Misterobots/Model_Work/docs/img/fit_side.png

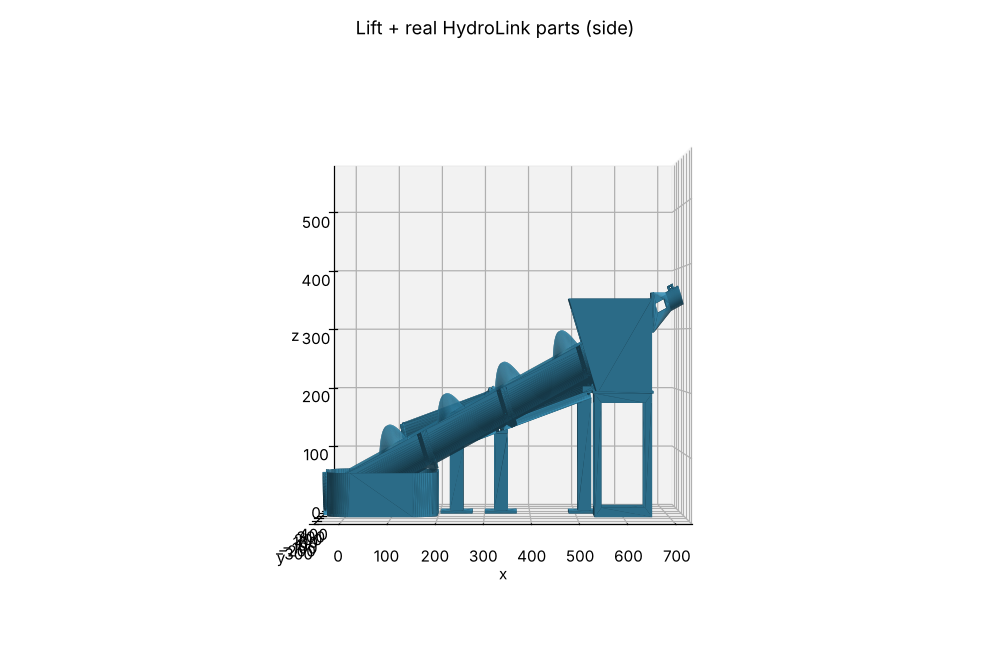
docs/img/fit_side.png
