Misterobots/Model_Work/docs/img/fit_top.png

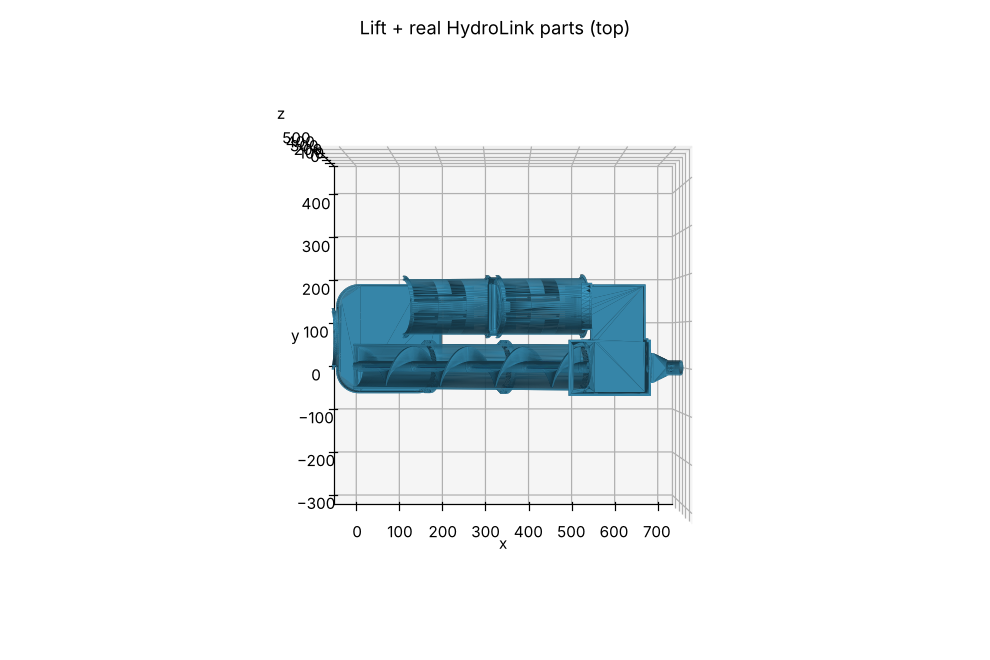
docs/img/fit_top.png
