Misterobots/Model_Work/docs/img/head_box.png

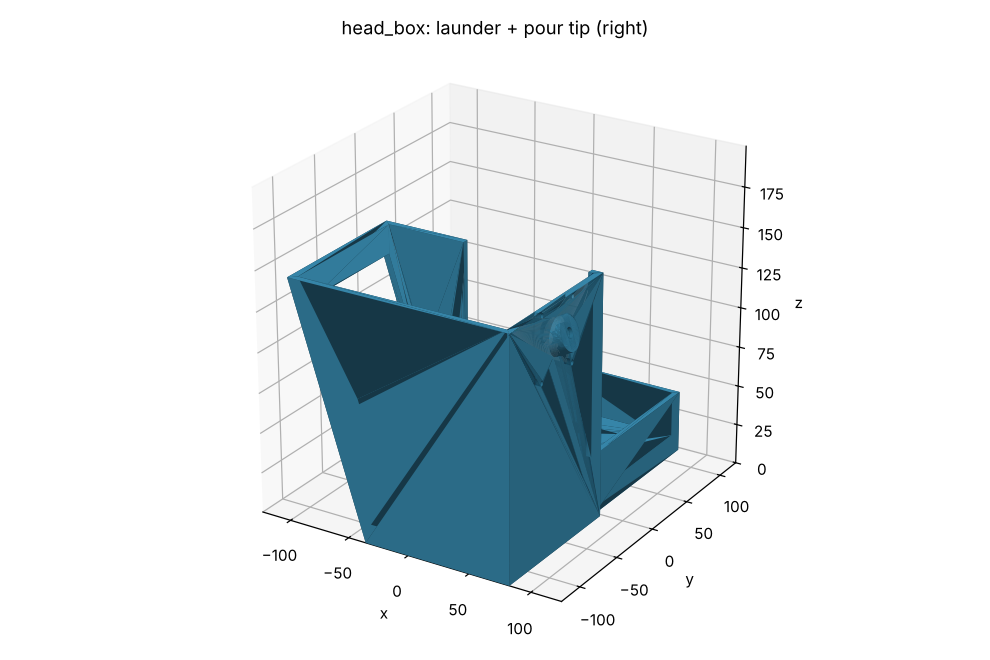
docs/img/head_box.png
