Misterobots/Model_Work/docs/img/screw_segment.png

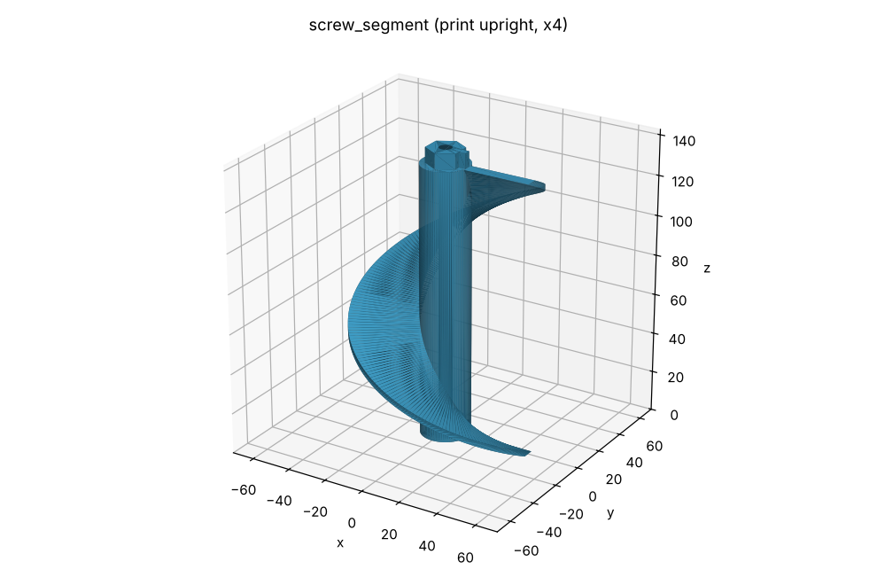
docs/img/screw_segment.png
