Misterobots/Model_Work/docs/img/trough_tail.png

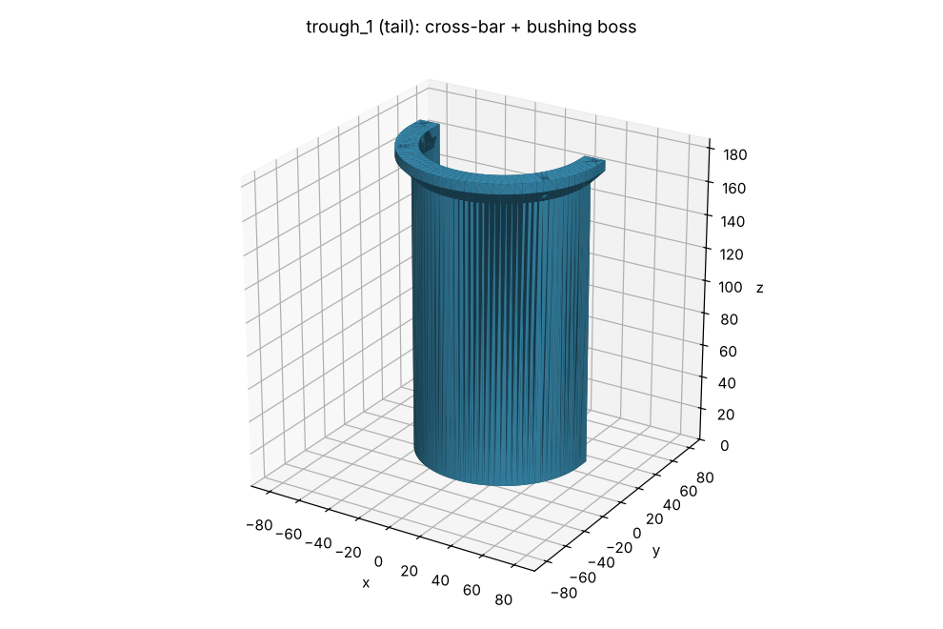
docs/img/trough_tail.png
