Misterobots/Model_Work/cad/lift/stl/_assembly.stl

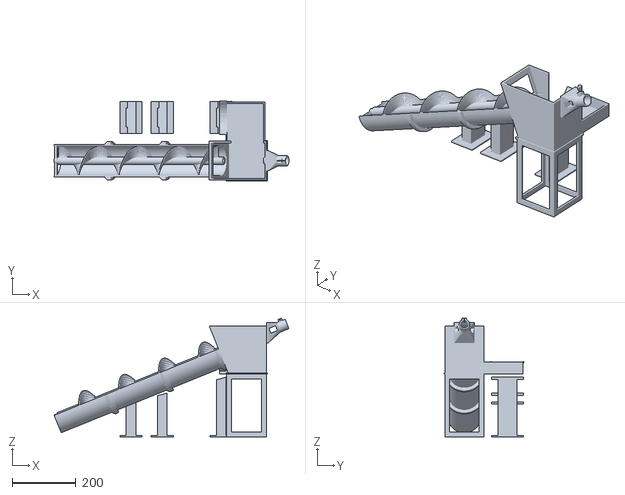
[picture p7: CAD file, 2026-10-11]
cad/lift/stl/_assembly.stl
737.1 x 251.4 x 372.4
