Misterobots/Model_Work/cad/lift/stl/riser_183mm.stl

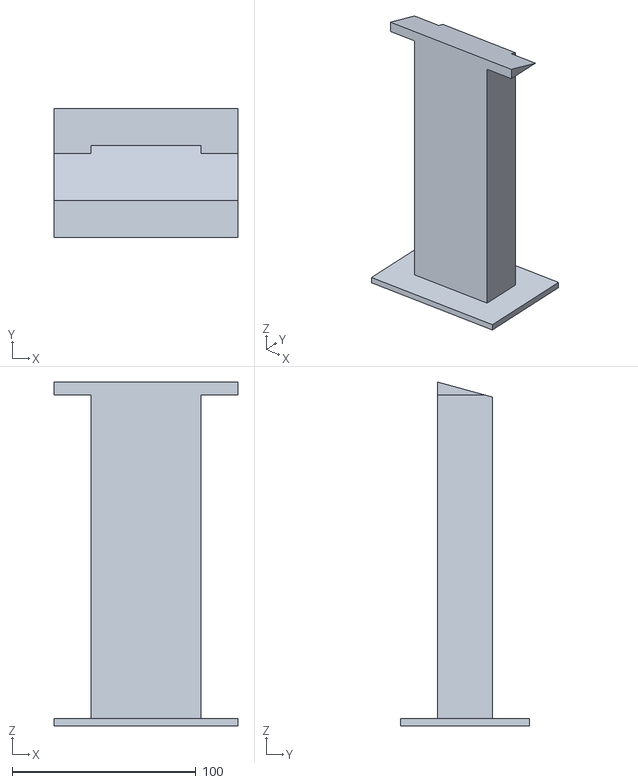
[picture p8: CAD file, 2026-10-11]
cad/lift/stl/riser_183mm.stl
100.0 x 70.0 x 187.1
