Misterobots/Model_Work/cad/lift/stl/head_box.stl

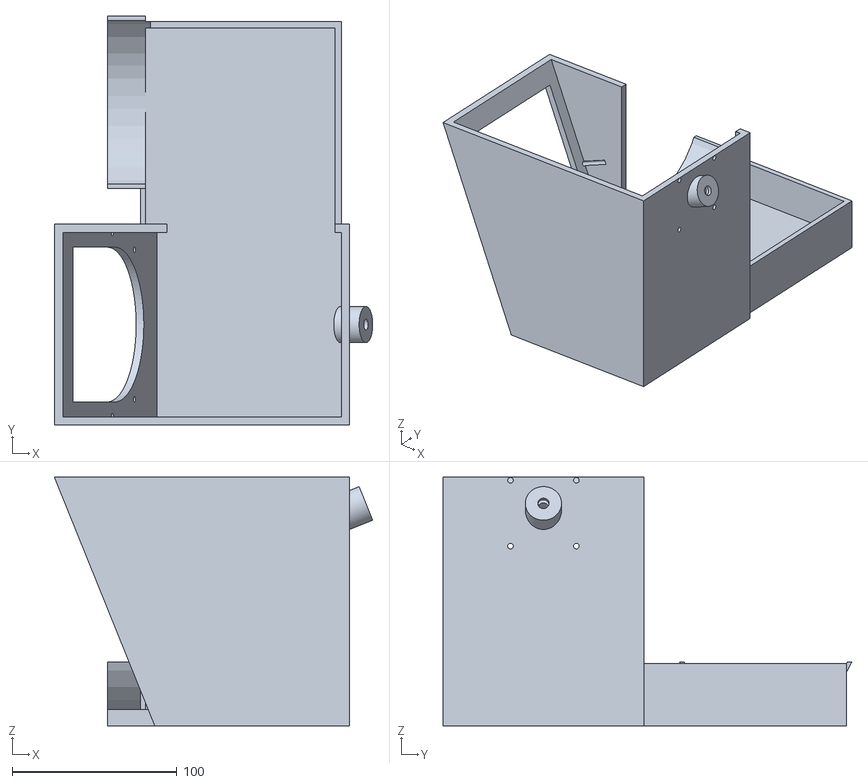
[picture p9: CAD file, 2026-10-11]
cad/lift/stl/head_box.stl
193.4 x 248.4 x 151.2
