Misterobots/Model_Work/cad/lift/stl/riser_106mm.stl

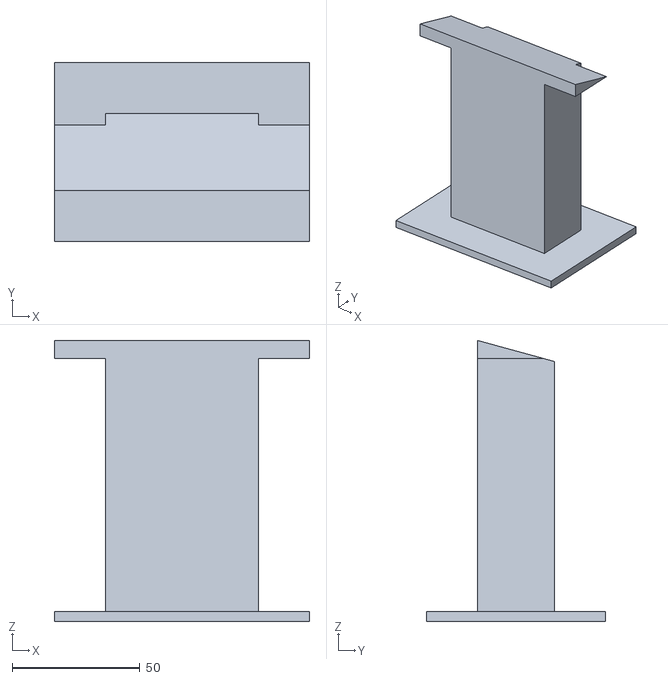
[picture p10: CAD file, 2026-10-11]
cad/lift/stl/riser_106mm.stl
100.0 x 70.0 x 110.1
