Misterobots/Model_Work/cad/lift/stl/riser_133mm.stl

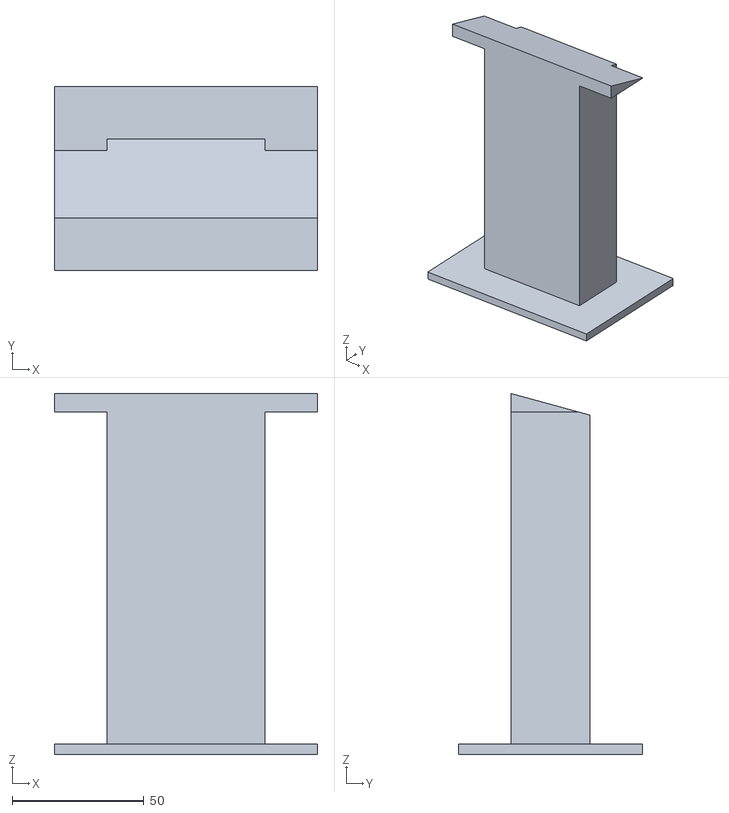
[picture p11: CAD file, 2026-10-11]
cad/lift/stl/riser_133mm.stl
100.0 x 70.0 x 137.1
