Misterobots/Model_Work/cad/lift/stl/trough_3_of_3_top.stl

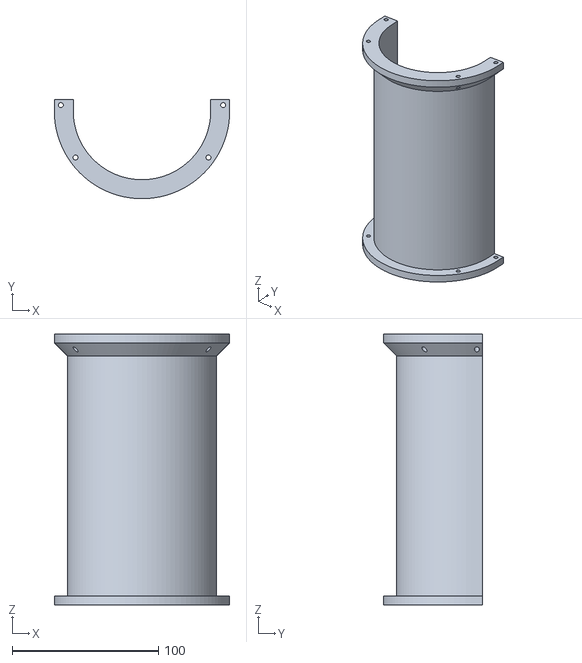
[picture p12: CAD file, 2026-10-11]
cad/lift/stl/trough_3_of_3_top.stl
120.0 x 68.0 x 185.3
