Misterobots/Model_Work/cad/lift/stl/head_box_stand.stl

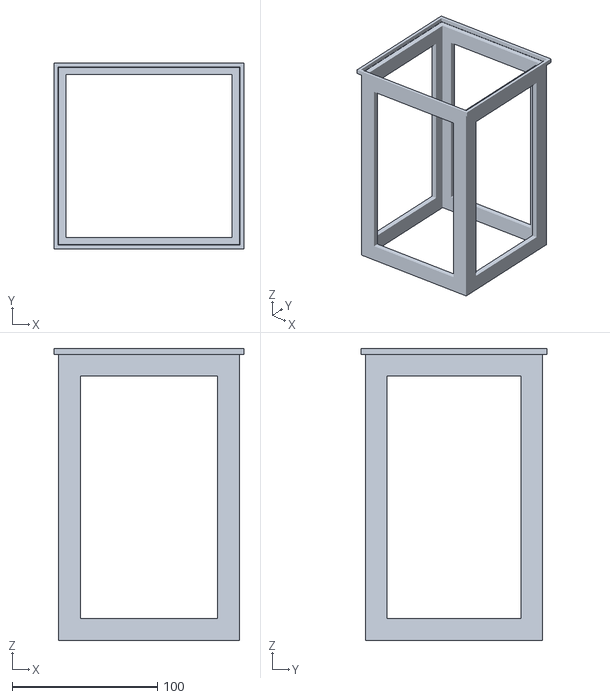
[picture p13: CAD file, 2026-10-11]
cad/lift/stl/head_box_stand.stl
130.4 x 128.0 x 200.9
