Misterobots/Model_Work/cad/lift/stl/drive_hub.stl

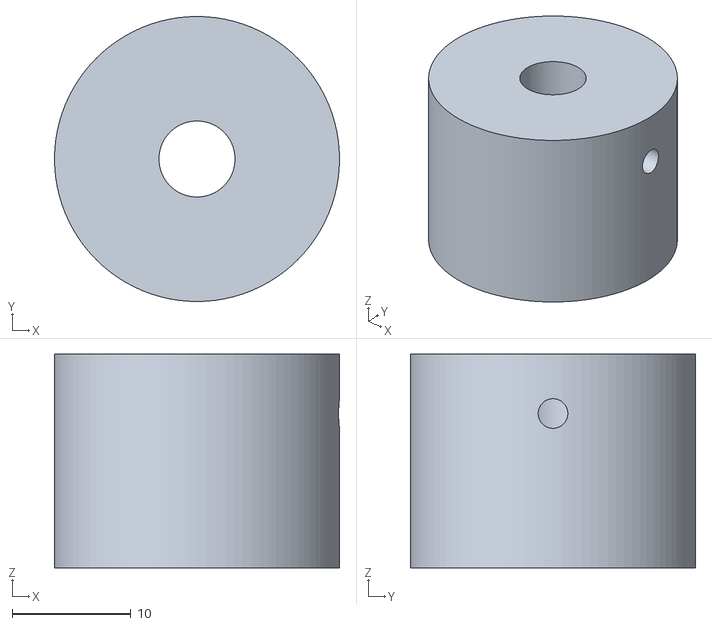
[picture p14: CAD file, 2026-10-11]
cad/lift/stl/drive_hub.stl
24.0 x 24.0 x 18.0
