Misterobots/Model_Work/cad/lift/stl/trough_1_of_3_tail.stl

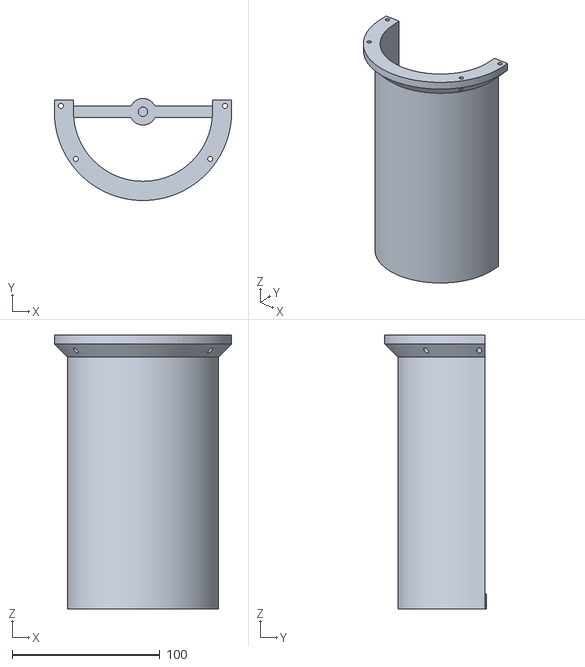
[picture p15: CAD file, 2026-10-11]
cad/lift/stl/trough_1_of_3_tail.stl
120.0 x 69.0 x 185.3
