Misterobots/Model_Work/cad/lift/stl/motor_hood.stl

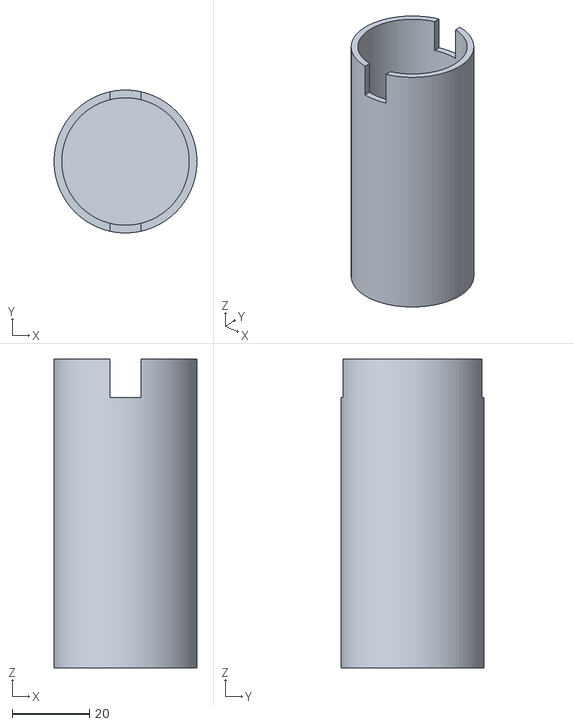
[picture p16: CAD file, 2026-10-11]
cad/lift/stl/motor_hood.stl
37.0 x 37.0 x 80.0
