Misterobots/Model_Work/cad/lift/stl/motor_mount.stl

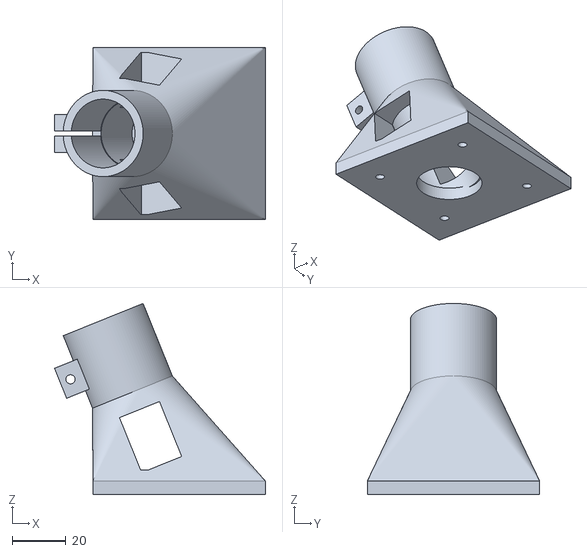
[picture p17: CAD file, 2026-10-11]
cad/lift/stl/motor_mount.stl
78.3 x 64.0 x 70.9
