Misterobots/Model_Work/cad/lift/stl/screw_segment_x4.stl

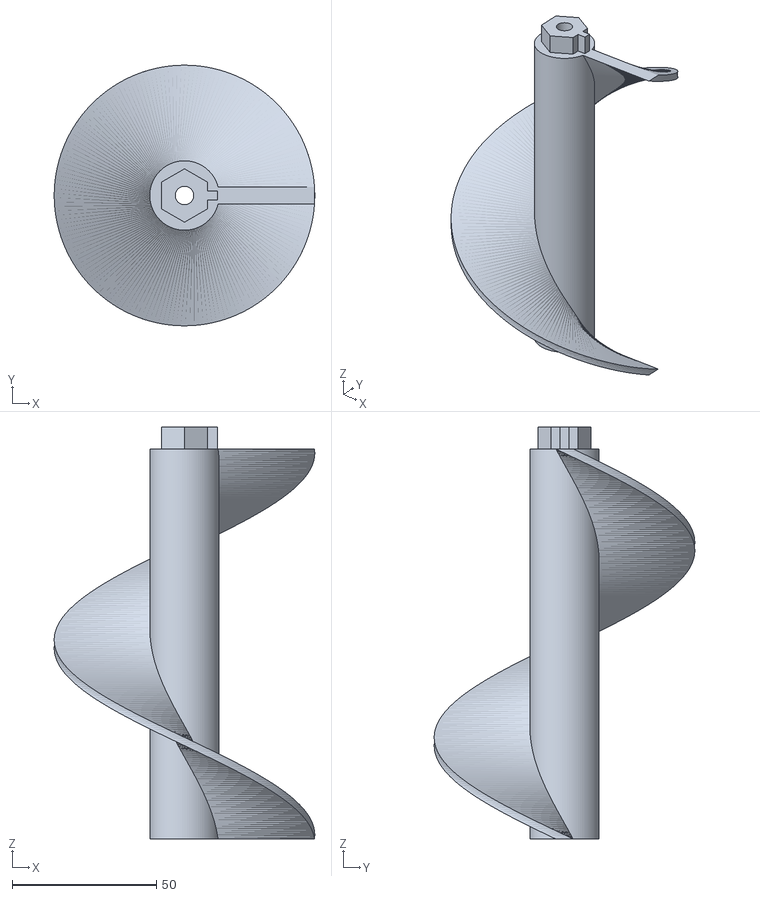
[picture p18: CAD file, 2026-10-11]
cad/lift/stl/screw_segment_x4.stl
90.2 x 90.2 x 142.6
