Misterobots/Model_Work/(list of files, cad)

Other CAD files:
cad/lift/stl/trough_2_of_3.stl
